c3303516/PingPongLauncher/PINOUT.xlsx

MOTORS |  | PWM | PHASE | ENCODER A | ENODER B |  | TIMER | CHANNEL
LAUNCHER | MOTOR 1 | PA6 | PA15 | PC10 | PC11 |  | TIM3 | 1 | FIRST ON LEFT, EN2
 | MOTOR 2 | PB10 | PA15? SAME | PC0 | PA0 |  | TIM2 | 3 | SECOND
 | MOTOR 3 | PB7 | PA15 | PC8 | PC9 | A4 and c4? | TIM4 | 2 | THIRD
 | AZIMUTH | b6 | b13 | PB1 | PC4 |  | TIM4 | 1 | Top RIGHT of PBb
 | ELEVATION | a7 | b14 | PC2 | PC3 |  | TIM3 | 2 | TOP LEFT OF PCB
 | SERVO | pb9 |  |  |  |  | TIM11 | 1
 |  |  |  | Enc A | Enc B |  | CHECK DRIVER CONNECTIONS
 | wire colour | WHOTE | YELLOPW | yellow | white
 |  |  |  |  |  |  |  |  | CHANGE PB5 O PA15
 |  |  |  | O1 | O2
 |  |  |  | green | yellow
