c3303516/PingPongLauncher/Components.xlsx

COMPONENT | QUANTITY | DETAILS | prine | Price subtotal | QUANTITY ORDERED | LINK
LAUNCHER
STM32L476 | 1
Pololu 5:1 MicroMetal | 3 | Needs to be dual shaft with magnetic encoder. Gear Ratio up for discussion Used for flywheels | 40.25 | 120.75 | 3 | https://core-electronics.com.au/5-1-micro-metal-gearmotor-hpcb-6v-with-extended-motor-shaft.html
Magnetic encoder | 2 | 12cpr, pair pack | 13.65 | 27.3 | 2 | https://core-electronics.com.au/magnetic-encoder-pair-kit-with-side-entry-connector-for-micro-metal-gearmotors-12-cpr-2-7-18v.html
DRV8835 Dual Motor Driver Carrier | 2 | Dual motor driver. Buy 3 and don’t use servo? | 8.5 | 17 | 3 | https://core-electronics.com.au/drv8835-dual-motor-driver-carrier.html
DRV8838 Single Motor Driver Carrier | 1 | single motor driver | 7.7 | 7.7 | 0 | https://core-electronics.com.au/drv8838-single-brushed-dc-motor-driver-carrier.html
Nd20 DC Motor - 6V 1:298 | 2 | Elevation and azimuth DC motors. 1:100 might be fine | 27.5 | 55 | 2 | https://core-electronics.com.au/n20-dc-motor-with-magnetic-encoder-6v-with-1-298-gear-ratio.html
Pololu Motor Bracket (pair) | 2 |  | 8.5 | 17 | 2 | https://core-electronics.com.au/pololu-micro-metal-gearmotor-bracket-extended-pair.html
jst-h bradided cables | 3 | 40cm. Connects breakout poins to motors | 5.15 | 15.45 | 3
jst breakout pin boards | 1 | set of 3, untested | 4.3 | 4.3 | 1 | https://core-electronics.com.au/voltage-regulator-5v.html
 |  |  |  | 0
dome button | 1 | big red | 25.36 | 25.36 | 1
12mm hex hubs | 1 | pair. With set screws , this should be good to lock in azimuth | 8.65 | 8.65 | 1
0.1uF capacitors | 1 | for voltage regulator | 0.53 | 0.53 | 2
 |  |  |  | 0
 |  |  |  | 0
 |  |  |  | 0
 |  |  |  | 0
 |  |  |  | 0
 |  |  |  | 0
 |  |  |  | 0
 |  |  |  | 0
 |  |  |  | 0
 |  |  |  | 0
 |  |  |  | 0
 |  |  |  | 0
 |  |  |  | 0
To |  | Total |  | 299.04
gear ratio | rpm | FLYWHEEL DIAMETER | est launch velocity m/s | km/h |  |  | stm size
10 | 3300 | 50 | 17.27875959 | 62.20353454 |  |  |  | 65x50
30 | 1100 | 50 | 5.759586532 | 20.73451151
50 | 650 | 50 | 3.403392041 | 12.25221135
5 | 6500 | 50 | 34.03392041 | 122.5221135
