c3303516/PingPongLauncher/TM_MPU6050/tm_stm32_gpio.c

/** 
 * |----------------------------------------------------------------------
 * | Copyright (c) 2016 Tilen Majerle
 * |  
 * | Permission is hereby granted, free of charge, to any person
 * | obtaining a copy of this software and associated documentation
 * | files (the "Software"), to deal in the Software without restriction,
 * | including without limitation the rights to use, copy, modify, merge,
 * | publish, distribute, sublicense, and/or sell copies of the Software, 
 * | and to permit persons to whom the Software is furnished to do so, 
 * | subject to the following conditions:
 * | 
 * | The above copyright notice and this permission notice shall be
 * | included in all copies or substantial portions of the Software.
 * | 
 * | THE SOFTWARE IS PROVIDED "AS IS", WITHOUT WARRANTY OF ANY KIND,
 * | EXPRESS OR IMPLIED, INCLUDING BUT NOT LIMITED TO THE WARRANTIES
 * | OF MERCHANTABILITY, FITNESS FOR A PARTICULAR PURPOSE
 * | AND NONINFRINGEMENT. IN NO EVENT SHALL THE AUTHORS OR COPYRIGHT
 * | HOLDERS BE LIABLE FOR ANY CLAIM, DAMAGES OR OTHER LIABILITY,
 * | WHETHER IN AN ACTION OF CONTRACT, TORT OR OTHERWISE, ARISING 
 * | FROM, OUT OF OR IN CONNECTION WITH THE SOFTWARE OR THE USE OR
 * | OTHER DEALINGS IN THE SOFTWARE.
 * |----------------------------------------------------------------------
 */
#include "tm_stm32_gpio.h"

/* Private function */
static uint16_t GPIO_UsedPins[13] = {0,0,0,0,0,0,0,0,0,0,0,0,0};

/* Private functions */
void TM_GPIO_INT_EnableClock(GPIO_TypeDef* GPIOx);
void TM_GPIO_INT_DisableClock(GPIO_TypeDef* GPIOx);
void TM_GPIO_INT_Init(GPIO_TypeDef* GPIOx, uint16_t GPIO_Pin, TM_GPIO_Mode_t GPIO_Mode, TM_GPIO_OType_t GPIO_OType, TM_GPIO_PuPd_t GPIO_PuPd, TM_GPIO_Speed_t GPIO_Speed);

void TM_GPIO_Init(GPIO_TypeDef* GPIOx, uint16_t GPIO_Pin, TM_GPIO_Mode_t GPIO_Mode, TM_GPIO_OType_t GPIO_OType, TM_GPIO_PuPd_t GPIO_PuPd, TM_GPIO_Speed_t GPIO_Speed) { 
    /* Check input */
    if (GPIO_Pin == 0x00) {
        return;
    }
    
    /* Enable clock for GPIO */
    TM_GPIO_INT_EnableClock(GPIOx);
    
    /* Do initialization */
    TM_GPIO_INT_Init(GPIOx, GPIO_Pin, GPIO_Mode, GPIO_OType, GPIO_PuPd, GPIO_Speed);
}

void TM_GPIO_InitAlternate(GPIO_TypeDef* GPIOx, uint16_t GPIO_Pin, TM_GPIO_OType_t GPIO_OType, TM_GPIO_PuPd_t GPIO_PuPd, TM_GPIO_Speed_t GPIO_Speed, uint8_t Alternate) {
    uint32_t pinpos;

    /* Check input */
    if (GPIO_Pin == 0x00) {
        return;
    }
    
    /* Enable GPIOx clock */
    TM_GPIO_INT_EnableClock(GPIOx);
    
    /* Set alternate functions for all pins */
    for (pinpos = 0; pinpos < 0x10; pinpos++) {
        /* Check pin */
        if ((GPIO_Pin & (1 << pinpos)) == 0) {
            continue;
        }
        
        /* Set alternate function */
        GPIOx->AFR[pinpos >> 0x03] = (GPIOx->AFR[pinpos >> 0x03] & ~(0x0F << (4 * (pinpos & 0x07)))) | (Alternate << (4 * (pinpos & 0x07)));
    }
    
    /* Do initialization */
    TM_GPIO_INT_Init(GPIOx, GPIO_Pin, TM_GPIO_Mode_AF, GPIO_OType, GPIO_PuPd, GPIO_Speed);
}

void TM_GPIO_DeInit(GPIO_TypeDef* GPIOx, uint16_t GPIO_Pin) {
    uint8_t i;
    uint8_t ptr = TM_GPIO_GetPortSource(GPIOx);
    
    /* Go through all pins */
    for (i = 0x00; i < 0x10; i++) {
        /* Pin is set */
        if (GPIO_Pin & (1 << i)) {
            /* Set 11 bits combination for analog mode */
            GPIOx->MODER |= (0x03 << (2 * i));
            
            /* Pin is not used */
            GPIO_UsedPins[ptr] &= ~(1 << i);
        }
    }
}

void TM_GPIO_SetPinAsInput(GPIO_TypeDef* GPIOx, uint16_t GPIO_Pin) {
    uint8_t i;
    /* Go through all pins */
    for (i = 0x00; i < 0x10; i++) {
        /* Pin is set */
        if (GPIO_Pin & (1 << i)) {
            /* Set 00 bits combination for input */
            GPIOx->MODER &= ~(0x03 << (2 * i));
        }
    }
}

void TM_GPIO_SetPinAsOutput(GPIO_TypeDef* GPIOx, uint16_t GPIO_Pin) {
    uint8_t i;
    /* Go through all pins */
    for (i = 0x00; i < 0x10; i++) {
        /* Pin is set */
        if (GPIO_Pin & (1 << i)) {
            /* Set 01 bits combination for output */
            GPIOx->MODER = (GPIOx->MODER & ~(0x03 << (2 * i))) | (0x01 << (2 * i));
        }
    }
}

void TM_GPIO_SetPinAsAnalog(GPIO_TypeDef* GPIOx, uint16_t GPIO_Pin) {
    uint8_t i;
    /* Go through all pins */
    for (i = 0x00; i < 0x10; i++) {
        /* Pin is set */
        if (GPIO_Pin & (1 << i)) {
            /* Set 11 bits combination for analog mode */
            GPIOx->MODER |= (0x03 << (2 * i));
        }
    }
}

void TM_GPIO_SetPinAsAlternate(GPIO_TypeDef* GPIOx, uint16_t GPIO_Pin) {
    uint8_t i;
    
    /* Set alternate functions for all pins */
    for (i = 0; i < 0x10; i++) {
        /* Check pin */
        if ((GPIO_Pin & (1 << i)) == 0) {
            continue;
        }
        
        /* Set alternate mode */
        GPIOx->MODER = (GPIOx->MODER & ~(0x03 << (2 * i))) | (0x02 << (2 * i));
    }
}

void TM_GPIO_SetPullResistor(GPIO_TypeDef* GPIOx, uint16_t GPIO_Pin, TM_GPIO_PuPd_t GPIO_PuPd) {
    uint8_t pinpos;
    
    /* Go through all pins */
    for (pinpos = 0; pinpos < 0x10; pinpos++) {
        /* Check if pin available */
        if ((GPIO_Pin & (1 << pinpos)) == 0) {
            continue;
        }

        /* Set GPIO PUPD register */
        GPIOx->PUPDR = (GPIOx->PUPDR & ~(0x03 << (2 * pinpos))) | ((uint32_t)(GPIO_PuPd << (2 * pinpos)));
    }
}

void TM_GPIO_Lock(GPIO_TypeDef* GPIOx, uint16_t GPIO_Pin) {
    uint32_t d;
    
    /* Set GPIO pin with 16th bit set to 1 */
    d = 0x00010000 | GPIO_Pin;
    
    /* Write to LCKR register */
    GPIOx->LCKR = d;
    GPIOx->LCKR = GPIO_Pin;
    GPIOx->LCKR = d;
    
    /* Read twice */
    (void)GPIOx->LCKR;
    (void)GPIOx->LCKR;
}

uint16_t TM_GPIO_GetPinSource(uint16_t GPIO_Pin) {
    uint16_t pinsource = 0;
    
    /* Get pinsource */
    while (GPIO_Pin > 1) {
        /* Increase pinsource */
        pinsource++;
        /* Shift right */
        GPIO_Pin >>= 1;
    }
    
    /* Return source */
    return pinsource;
}

uint16_t TM_GPIO_GetPortSource(GPIO_TypeDef* GPIOx) {
    /* Get port source number */
    /* Offset from GPIOA                       Difference between 2 GPIO addresses */
    return ((uint32_t)GPIOx - (GPIOA_BASE)) / ((GPIOB_BASE) - (GPIOA_BASE));
}

/* Private functions */
void TM_GPIO_INT_EnableClock(GPIO_TypeDef* GPIOx) {
    /* Set bit according to the 1 << portsourcenumber */
#if defined(STM32F0xx)
    RCC->AHBENR |= (1 << (TM_GPIO_GetPortSource(GPIOx) + 17));
#else
    RCC->AHB1ENR |= (1 << TM_GPIO_GetPortSource(GPIOx));
#endif
}

void TM_GPIO_INT_DisableClock(GPIO_TypeDef* GPIOx) {
    /* Clear bit according to the 1 << portsourcenumber */
#if defined(STM32F0xx)
    RCC->AHBENR &= ~(1 << (TM_GPIO_GetPortSource(GPIOx) + 17));
#else
    RCC->AHB1ENR &= ~(1 << TM_GPIO_GetPortSource(GPIOx));
#endif
}

void TM_GPIO_INT_Init(GPIO_TypeDef* GPIOx, uint16_t GPIO_Pin, TM_GPIO_Mode_t GPIO_Mode, TM_GPIO_OType_t GPIO_OType, TM_GPIO_PuPd_t GPIO_PuPd, TM_GPIO_Speed_t GPIO_Speed) {
    uint8_t pinpos;
    uint8_t ptr = TM_GPIO_GetPortSource(GPIOx);
    
#if defined(STM32F0xx)
    /* STM32F0xx series does not have FAST speed mode available */
    if (GPIO_Speed == TM_GPIO_Speed_Fast) {
        /* Set speed to high mode */
        GPIO_Speed = TM_GPIO_Speed_High;
    }
#endif
    
    /* Go through all pins */
    for (pinpos = 0; pinpos < 0x10; pinpos++) {
        /* Check if pin available */
        if ((GPIO_Pin & (1 << pinpos)) == 0) {
            continue;
        }
        
        /* Pin is used */
        GPIO_UsedPins[ptr] |= 1 << pinpos;
        
        /* Set GPIO PUPD register */
        GPIOx->PUPDR = (GPIOx->PUPDR & ~(0x03 << (2 * pinpos))) | ((uint32_t)(GPIO_PuPd << (2 * pinpos)));
        
        /* Set GPIO MODE register */
        GPIOx->MODER = (GPIOx->MODER & ~((uint32_t)(0x03 << (2 * pinpos)))) | ((uint32_t)(GPIO_Mode << (2 * pinpos)));
        
        /* Set only if output or alternate functions */
        if (GPIO_Mode == TM_GPIO_Mode_OUT || GPIO_Mode == TM_GPIO_Mode_AF) {        
            /* Set GPIO OTYPE register */
            GPIOx->OTYPER = (GPIOx->OTYPER & ~(uint16_t)(0x01 << pinpos)) | ((uint16_t)(GPIO_OType << pinpos));
            
            /* Set GPIO OSPEED register */
            GPIOx->OSPEEDR = (GPIOx->OSPEEDR & ~((uint32_t)(0x03 << (2 * pinpos)))) | ((uint32_t)(GPIO_Speed << (2 * pinpos)));
        }
    }
}

uint16_t TM_GPIO_GetUsedPins(GPIO_TypeDef* GPIOx) {
    /* Return used */
    return GPIO_UsedPins[TM_GPIO_GetPortSource(GPIOx)];
}

uint16_t TM_GPIO_GetFreePins(GPIO_TypeDef* GPIOx) {
    /* Return free pins */
    return ~GPIO_UsedPins[TM_GPIO_GetPortSource(GPIOx)];
}
