c3303516/PingPongLauncher/(commit log)

2023-10-20 Working PWM and Encoder for 1 motor.
2023-10-23 enc now has 2 pins for exti. control timer reintegrated
2023-10-24 Implemented PID. Needs tuning, and needs to allow neg u values
2023-10-25 Tuning PID. might be better to do in terms of RPM
2023-10-26 Controller now works to track Revs/sec
2023-11-01 fixed control for launcher
    [control_loop.c, controller.c, motor.c, motor.h]
2023-11-03 Elevation N20 now working with encoders!! will replicate for azi
2023-11-16 Fixed ALL motor and encoder pinouts. awaiting on testing
    [control_loop.c, controller.h, motor.c, motor.h]
2023-11-17 Heartbeat and serial connection not working.
    [control_loop.c, dummy_task.c, main.c, motor.c, motor.h]
2023-11-22 All motors working with the current pins!
2023-11-23 Servo now working! will require physical calibration
2023-12-08 ELe and azi good. somethings wrong iwth encoders for launcher motors
    [cmd_parser.c, control_loop.c, controller.c, motor.c]
2023-12-11 Fixed Launchers. Control loop now controls RPM
    [control_loop.c, controller.c, motor.c]
2023-12-11 Code finalised. Launcher logic works.Calibration logic works
2023-12-12 Compiling all relevant files to project
    [Components.xlsx, PINOUT.xlsx]
2023-12-13 ALL DONE. ELE COULD USE SOME TUNING CAUSE THE GEARS AREN'T EXACT BUT CONTROL IS GOOD
